banoz/ER-TFT1.28-1.Breakout/README.md

# ER-TFT1.28-1.Breakout
1.28" round TFT display breakout board based on ESP32-S3-BOX schematics.

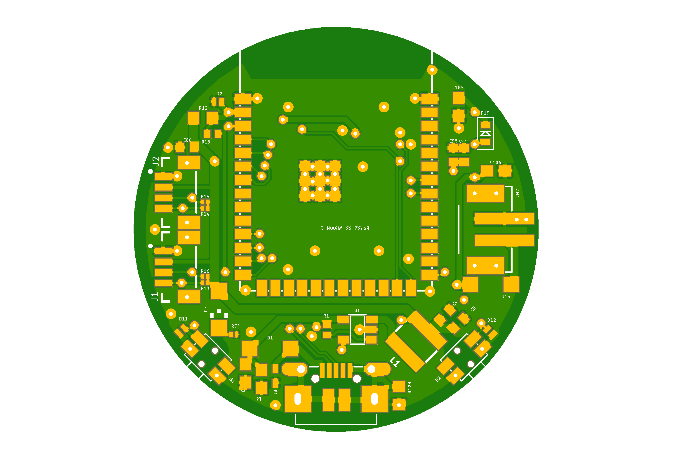
[picture p1: project/Exports/Breakout_top.png]
TOP
