banoz/ER-TFT1.28-1.Breakout/project/Exports/Breakout_bottom.png

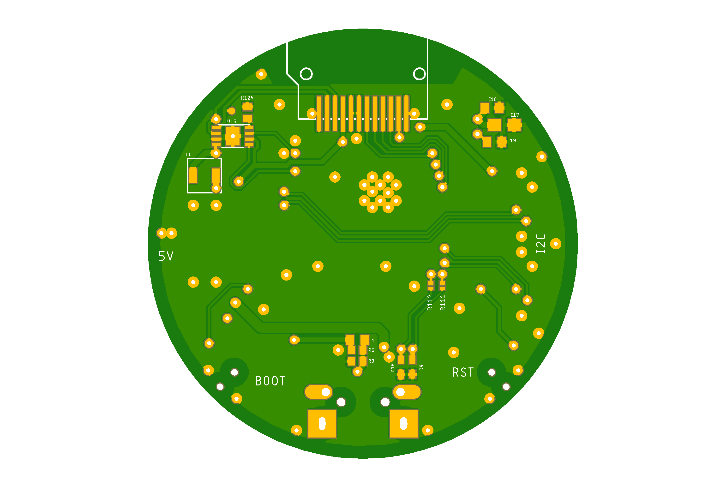
project/Exports/Breakout_bottom.png
