banoz/ER-TFT1.28-1.Breakout/project/Exports/Breakout_sch_1.png

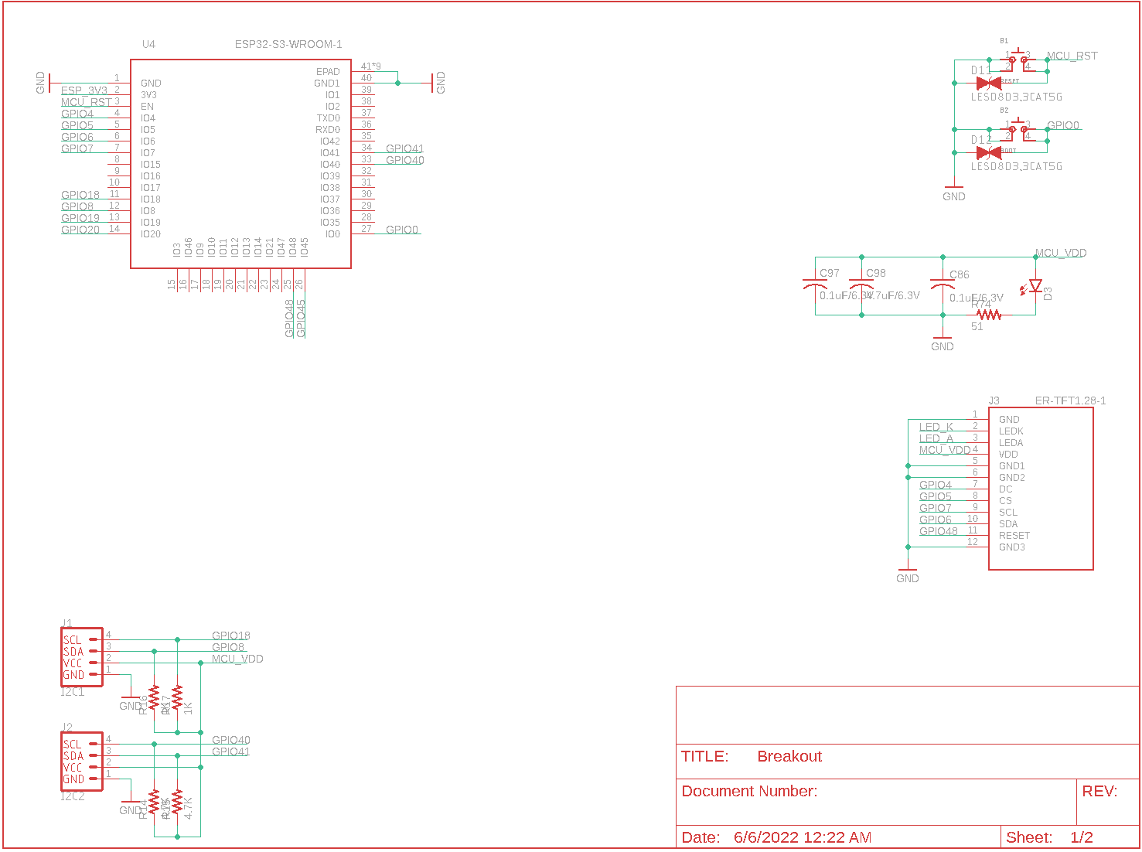
project/Exports/Breakout_sch_1.png
