banoz/ER-TFT1.28-1.Breakout/project/Breakout.brd

## EAGLE design project/Breakout.brd (2022-06-18)

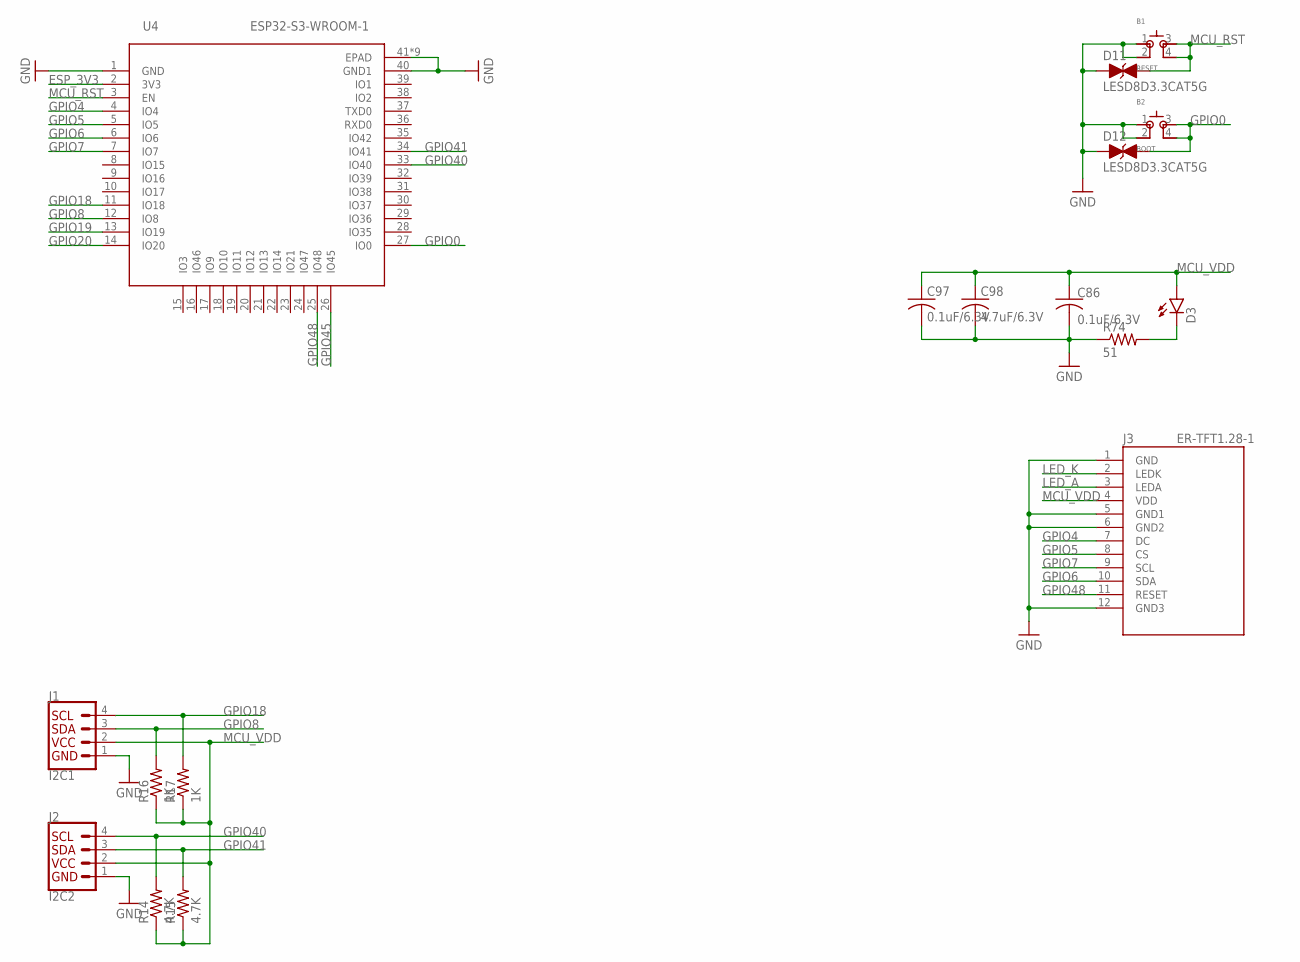
[picture p5: schematic Breakout.sch, sheet 1]

Parts:
B1: RESET; SKSCLDE010; LCSC C115362
B2: BOOT; SKSCLDE010; LCSC C115362
C86, C97: 0.1uF/6.3V; C0402; LCSC C541406
C98: 4.7uF/6.3V; C0402; LCSC C106859
D3: LEDCHIPLED_1206; CHIPLED_1206; LCSC C375534
D11, D12: LESD8D3.3CAT5G; SOD882; LCSC C172409
J1: I2C1; JST04_1MM_VERT; LCSC C495539
J2: I2C2; JST04_1MM_VERT; LCSC C495539
J3: ER-TFT1.28-1; 12P-FPC
R14, R15: 4.7K; R0201; LCSC C138135
R16, R17: 1K; R0201; LCSC C138165
R74: 51; R0201; LCSC C163499
U4: ESP32-S3-WROOM-1; QFN60_ESP32-S3-WROOM-1_EXP

Connections:
ESP_3V3: U4.2 (3V3); also elsewhere on the board
GND: B1.1, B1.2, B2.1, B2.2, C86.2, C97.2, C98.2, D11.A, D12.A, J1.1, J2.1, J3.1 (GND), J3.5 (GND1), J3.6 (GND2), J3.12 (GND3), R74.1, U4.1 (GND), U4.40 (GND1), U4.41 (EPAD), U4.42 (EPAD), U4.43 (EPAD), U4.44 (EPAD), U4.45 (EPAD), U4.46 (EPAD), U4.47 (EPAD), U4.48 (EPAD), U4.49 (EPAD); also elsewhere on the board
GPIO0: B2.3 (4), B2.4 (3), D12.C, U4.27 (IO0)
GPIO4: J3.7 (DC), U4.4 (IO4)
GPIO5: J3.8 (CS), U4.5 (IO5)
GPIO6: J3.10 (SDA), U4.6 (IO6)
GPIO7: J3.9 (SCL), U4.7 (IO7)
GPIO8: J1.3, R16.2, U4.12 (IO8)
GPIO18: J1.4, R17.2, U4.11 (IO18)
GPIO19: U4.13 (IO19); also elsewhere on the board
GPIO20: U4.14 (IO20); also elsewhere on the board
GPIO40: J2.4, R14.2, U4.33 (IO40)
GPIO41: J2.3, R15.2, U4.34 (IO41)
GPIO45: U4.26 (IO45); also elsewhere on the board
GPIO48: J3.11 (RESET), U4.25 (IO48); also elsewhere on the board
LED_A: J3.3 (LEDA); also elsewhere on the board
LED_K: J3.2 (LEDK); also elsewhere on the board
MCU_RST: B1.3 (4), B1.4 (3), D11.C, U4.3 (EN); also elsewhere on the board
MCU_VDD: C86.1, C97.1, C98.1, D3.A, J1.2, J2.2, J3.4 (VDD), R14.1, R15.1, R16.1, R17.1; also elsewhere on the board
unnamed: D3.C, R74.2

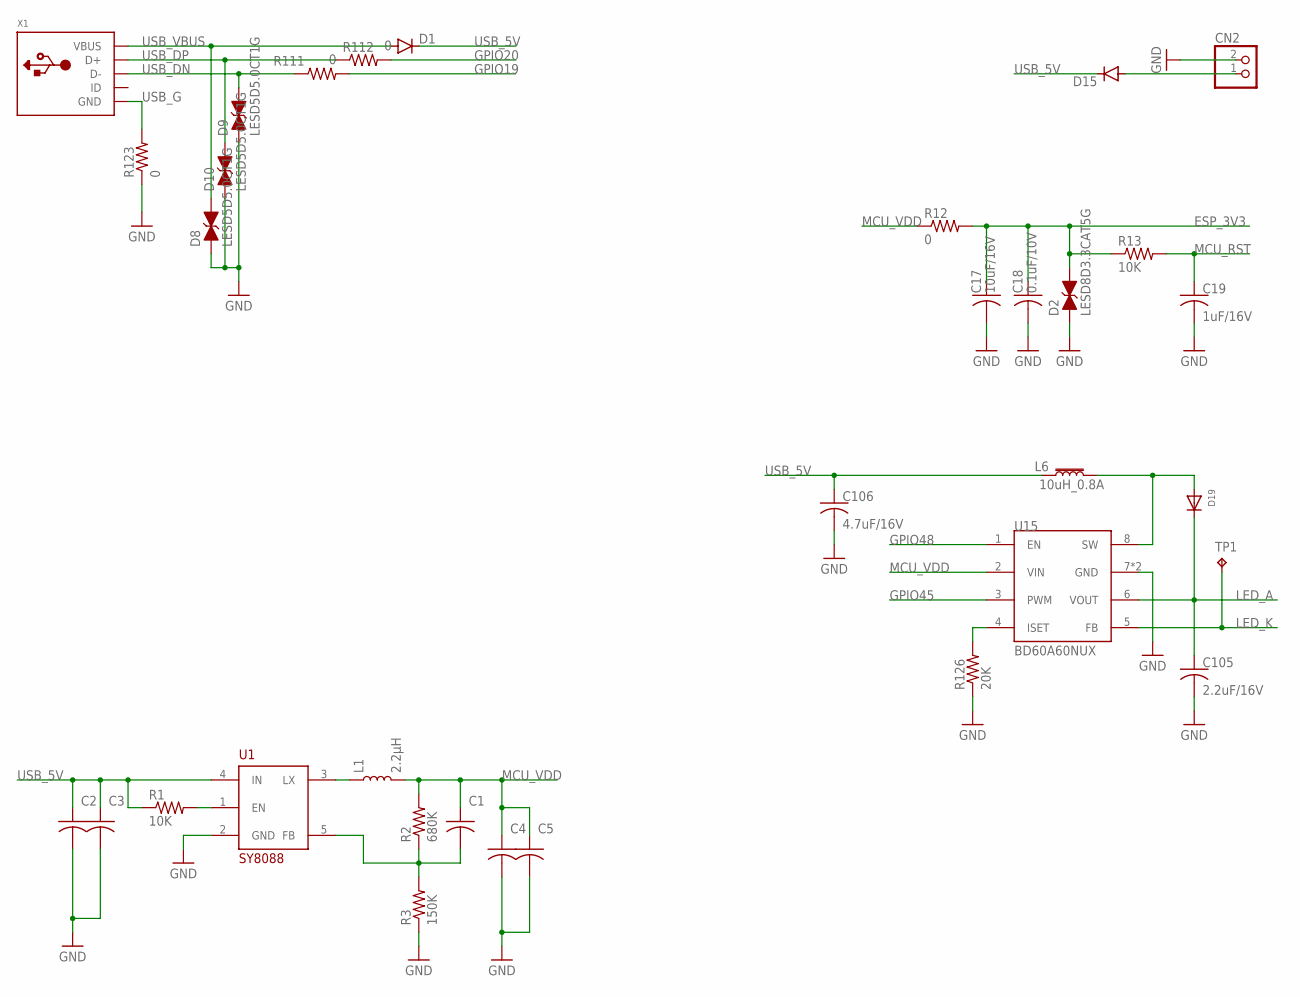
[picture p6: schematic Breakout.sch, sheet 2]

Parts:
C1: 22pF/50V; C0402; LCSC C106203
C2, C17: 10uF/16V; C0603; LCSC C86275
C3: 0.1uF/10V; C0603; LCSC C161163
C4, C18: 0.1uF/10V; C0402; LCSC C161163
C5: 10uF/16V; C0402; LCSC C86275
C19: 1uF/16V; C0402; LCSC C77007
C105: 2.2uF/16V; C0603; LCSC C106853
C106: 4.7uF/16V; C0603; LCSC C277476
CN2: JST_2PIN-SMT; JST-PH-2-SMT; LCSC C64658
D1, D15: DIODE-SOD123; SOD123; LCSC C511872
D2: LESD8D3.3CAT5G; SOD882; LCSC C172409
D8, D9, D10: LESD5D5.0CT1G; SOD523; LCSC C383211
D19: DIODESOD-523; SOD-523; LCSC C253516
L1: 2.2μH; INDUCTOR_4X4MM; LCSC C370436
L6: 10uH_0.8A; L3012S; LCSC C518881
R1, R13: 10K; R0402; LCSC C60490
R2: 680K; R0402; LCSC C163456
R3: 150K; R0402; LCSC C93947
R12, R123: 0; R0603; LCSC C100044
R111, R112: 0; R0201; LCSC C106227
R126: 20K; R0402; LCSC C326980
TP1: TPTP06R; TP06R
U1: SY8088; SOT23-5; LCSC C79313
U15: BD60A60NUX; VSON008X2030; LCSC C2678724
X1: MICROBUILDER_USBMICRO_20329; MICROBUILDER_4UCONN_20329; LCSC C40946

Connections:
ESP_3V3: C17.1, C18.1, D2.C, R12.2, R13.1; also elsewhere on the board
GND: C2.2, C3.2, C4.2, C5.2, C17.2, C18.2, C19.2, C105.2, C106.2, CN2.2 (1), D2.A, D8.A, D9.A, D10.A, R3.1, R123.1, R126.1, U1.2 (GND), U15.7 (GND), U15.PAD (GND); also elsewhere on the board
GPIO19: R111.2; also elsewhere on the board
GPIO20: R112.2; also elsewhere on the board
GPIO45: U15.3 (PWM); also elsewhere on the board
GPIO48: U15.1 (EN); also elsewhere on the board
LED_A: C105.1, D19.K (C), U15.6 (VOUT); also elsewhere on the board
LED_K: TP1.TP, U15.5 (FB); also elsewhere on the board
MCU_RST: C19.1, R13.2; also elsewhere on the board
MCU_VDD: C1.1, C4.1, C5.1, L1.P$2 (2), R2.2, R12.1, U15.2 (VIN); also elsewhere on the board
unnamed: D19.A, L6.P$2 (2), U15.8 (SW)
unnamed: CN2.1 (2), D15.A
unnamed: R1.2, U1.1 (EN)
unnamed: L1.P$1 (1), U1.3 (LX)
unnamed: C1.2, R2.1, R3.2, U1.5 (FB)
unnamed: R126.2, U15.4 (ISET)
USB_5V: C2.1, C3.1, C106.1, D1.C, D15.C, L6.P$1 (1), R1.1, U1.4 (IN)
USB_DN: D9.C, R111.1, X1.D-
USB_DP: D10.C, R112.1, X1.D+
USB_G: R123.2, X1.BASE@1 (GND), X1.BASE@2 (GND), X1.GND, X1.SPRT@1 (GND), X1.SPRT@2 (GND), X1.SPRT@3 (GND), X1.SPRT@4 (GND)
USB_VBUS: D1.A, D8.C, X1.VBUS

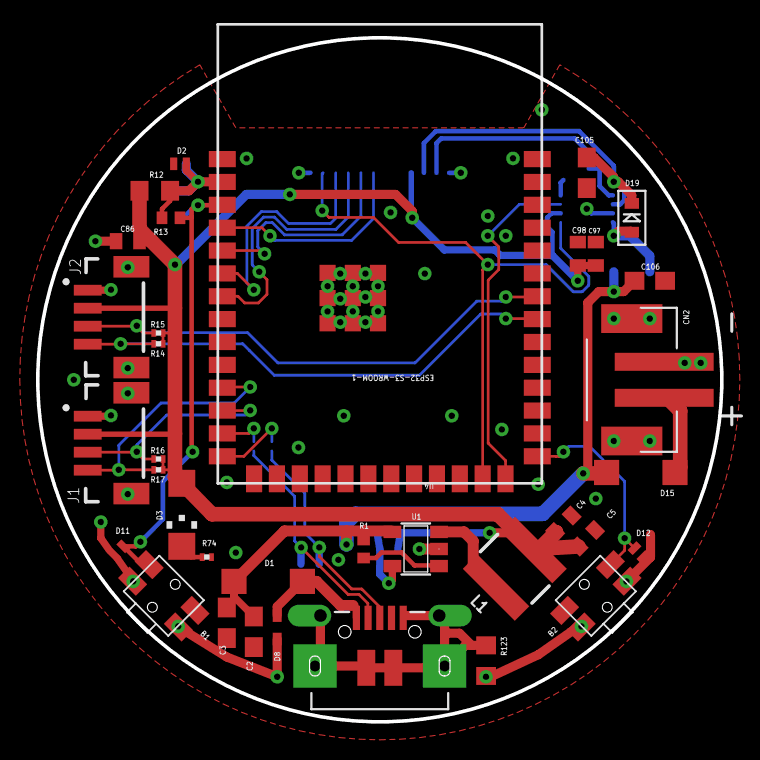
[picture p7: board Breakout.brd from above]

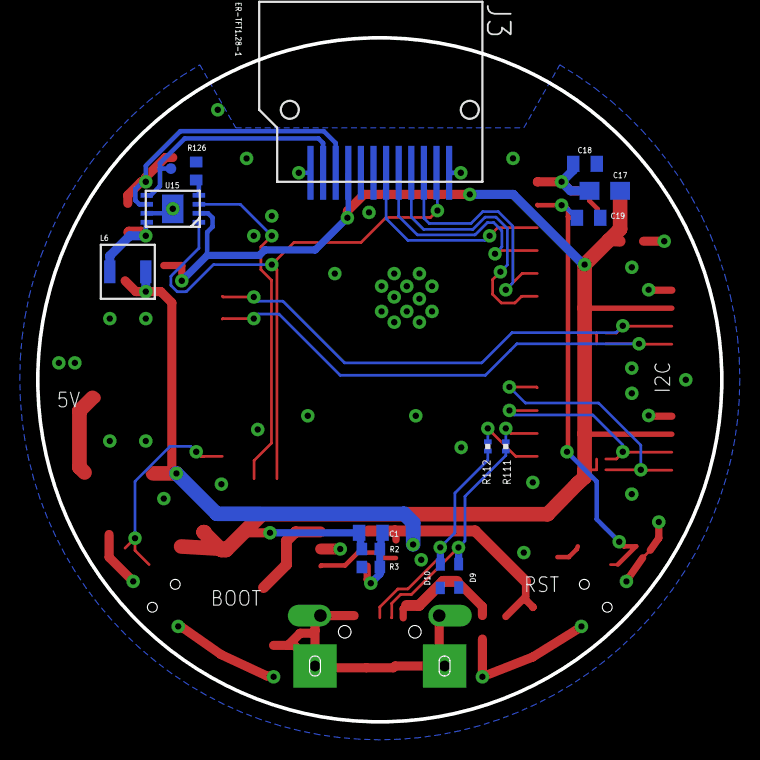
[picture p8: board Breakout.brd from below]

Board: 2 copper layers, 38.0 x 38.0 mm, 50 parts (15 on the bottom side), 31 nets.
