banoz/ER-TFT1.28-1.Breakout/(commit log)

2021-11-28 Initial state
    [Breakout.brd, Breakout.sch]
2021-12-09 Layout complete
    [Breakout.brd, Breakout.sch]
2022-05-07 cleanup and fixes
    [Breakout.brd, Breakout.sch]
2022-06-18 Display pinout fix
    [Breakout.brd, Breakout.sch]
